hoglet67/SBC09/kicad/54020-44030LF.stp

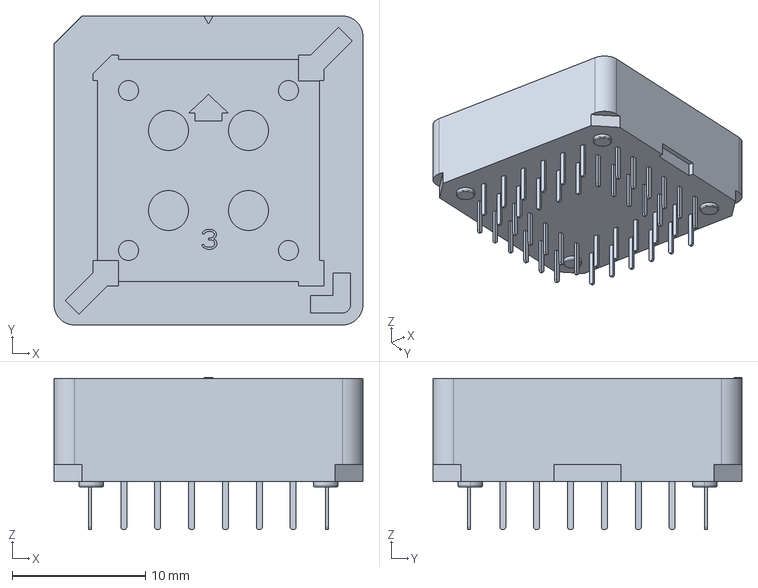
[picture p1: CAD file, 2023-04-21]
kicad/54020-44030LF.stp
23.2 x 23.2 x 11.4 mm
