hoglet67/SBC09/kicad/sbc09.pdf

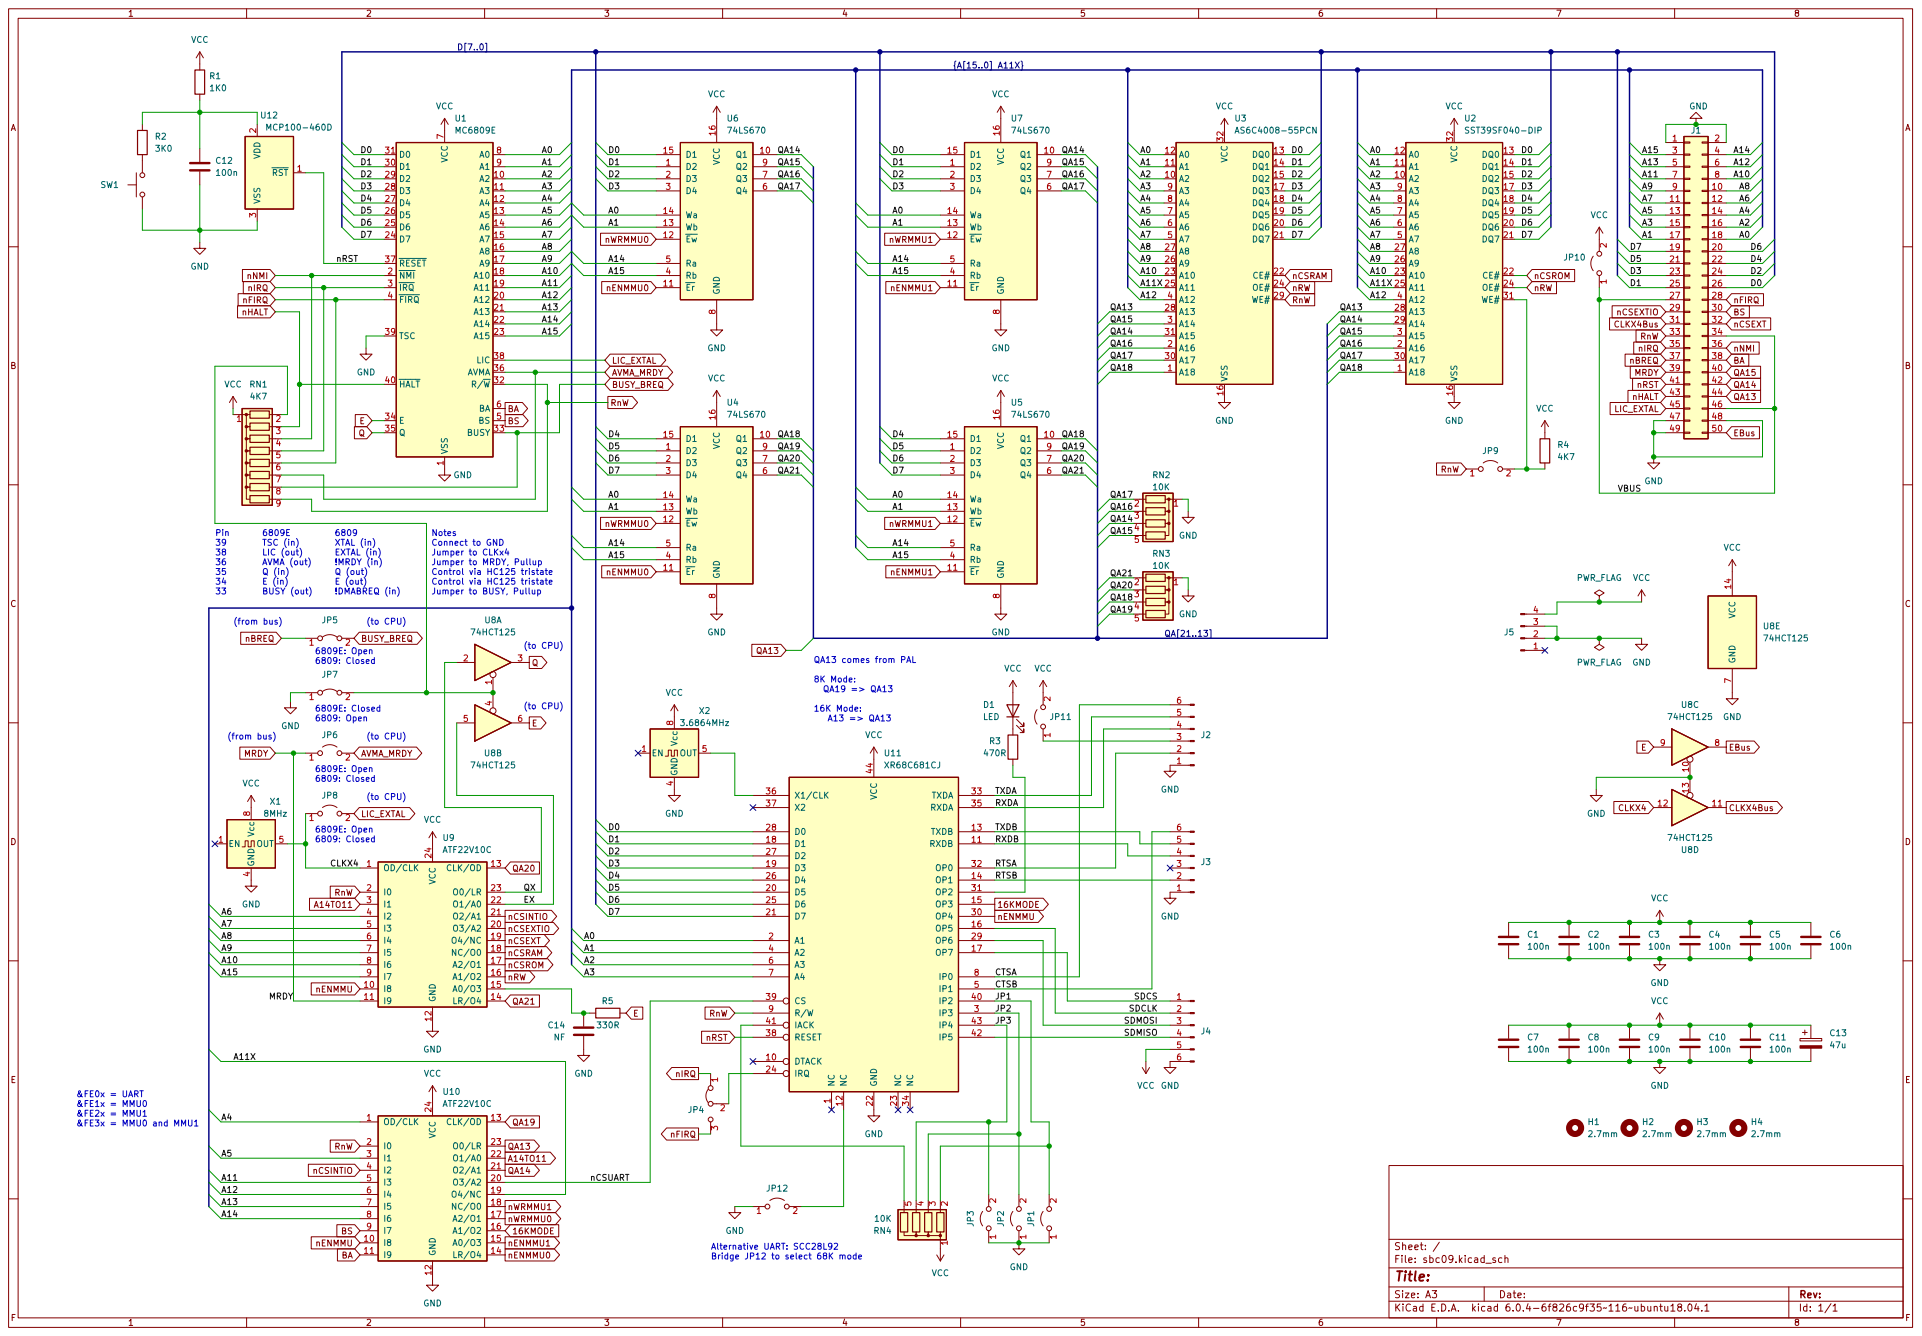
[picture p2: page 1]

38 LIC (out) EXTAL (in) Jumper to CLKx4
36 AVMA (out) !MRDY (in) Jumper to MRDY, Pullup
35 Q (in) Q (out) Control via HC125 tristate
34 E (in) E (out) Control via HC125 tristate
33 BUSY (out) !DMABREQ (in) Jumper to BUSY, Pullup

1 DTACK 10 RXDB 11 NC 12 TXDB 13 OP1 14 OP3 15 OP5 16 OP7 17 D1 18 D3 19 A1 2 D5 20 D7 21 GND 22 NC 23

Alternative UART: SCC28L92 Bridge JP12 to select 68K mode
