hoglet67/SBC09/kicad/sbc09.kicad_pcb

## KiCad design kicad/sbc09.kicad_pcb (2023-04-19)

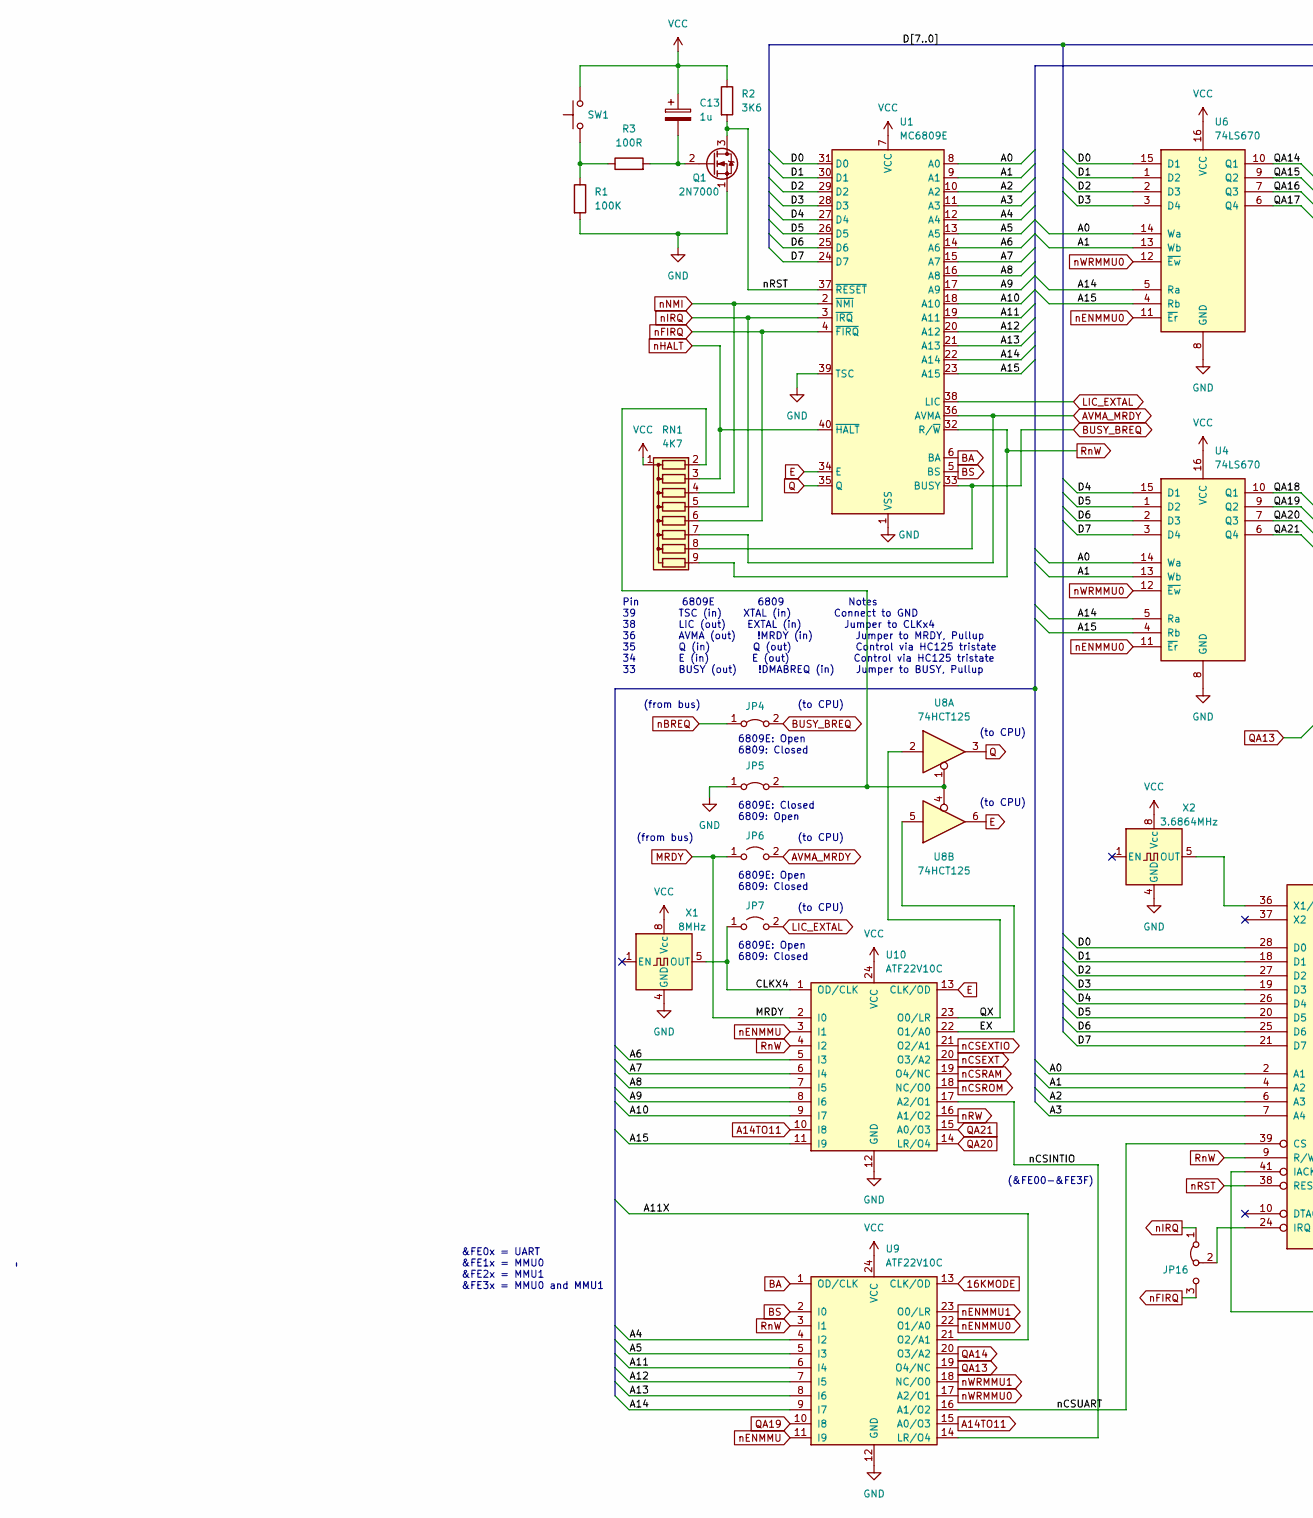
[picture p3: schematic sbc09.kicad_sch, part in row 1, column 1]

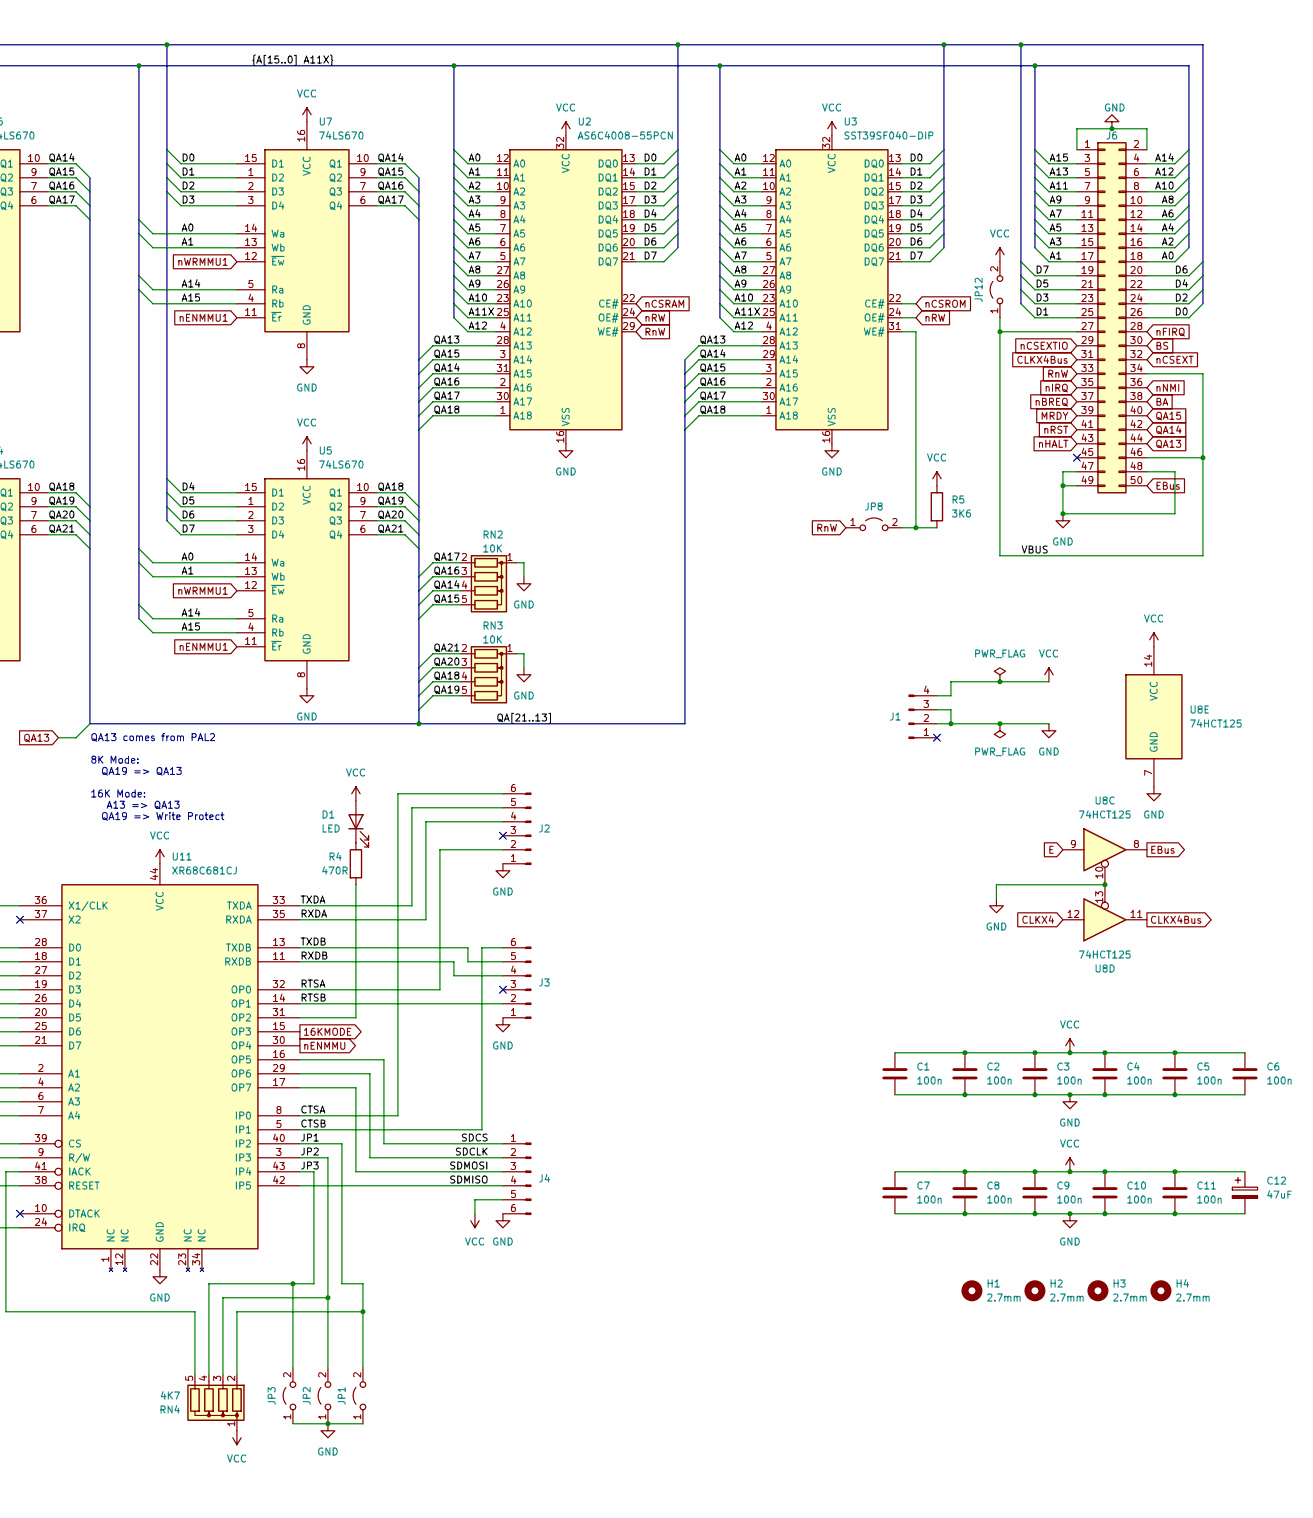
[picture p4: schematic sbc09.kicad_sch, part in row 1, column 2]

Parts:
C1, C2, C3, C4, C5, C6, C7, C8, C9, C10, C11: 100n; C_Disc_D4.7mm_W2.5mm_P5.00mm
C12: 47uF; CP_Radial_D5.0mm_P2.50mm
C13: 1u; CP_Radial_D5.0mm_P2.50mm
D1: LED; LED_D3.0mm_Horizontal_O1.27mm_Z2.0mm
H1, H2, H3, H4: 2.7mm; MountingHole_2.7mm
J1: Conn_01x04_Male; Molex_KK-254_AE-6410-04A_1x04_P2.54mm_Vertical
J2, J3, J4: Conn_01x06_Male; PinSocket_1x06_P2.54mm_Horizontal
J6: Conn_02x25_Odd_Even; IDC-Header_2x25_P2.54mm_Horizontal
JP1, JP2, JP3, JP6, JP7, JP8, JP12: Jumper_2_Open; PinHeader_1x02_P2.54mm_Vertical
JP4, JP5: Jumper_2_Bridged; PinHeader_1x02_P2.54mm_Vertical
JP16: Jumper_3_Bridged12; PinHeader_1x03_P2.54mm_Vertical
Q1: 2N7000; TO-92_Inline
R1: 100K; R_Axial_DIN0207_L6.3mm_D2.5mm_P10.16mm_Horizontal
R2, R5: 3K6; R_Axial_DIN0207_L6.3mm_D2.5mm_P10.16mm_Horizontal
R3: 100R; R_Axial_DIN0207_L6.3mm_D2.5mm_P10.16mm_Horizontal
R4: 470R; R_Axial_DIN0207_L6.3mm_D2.5mm_P10.16mm_Horizontal
RN1: 4K7; R_Array_SIP9
RN2, RN3: 10K; R_Array_SIP5
RN4: 4K7; R_Array_SIP5
SW1: SW_Push; SW_Tactile_SPST_Angled_PTS645Vx83-2LFS
U1: MC6809E; DIP-40_W15.24mm_Socket
U2: AS6C4008-55PCN; DIP-32_W15.24mm_Socket
U3: SST39SF040-DIP; DIP-32_W15.24mm_Socket
U4, U5, U6, U7: 74LS670; DIP-16_W7.62mm_Socket
U8: 74HCT125; DIP-14_W7.62mm_Socket
U9, U10: ATF22V10C; DIP-24_W7.62mm_Socket
U11: XR68C681CJ; PLCC-44_THT-Socket
X1: 8MHz; Oscillator_DIP-8
X2: 3.6864MHz; Oscillator_DIP-8

Connections:
16KMODE: U9.13 (CLK/OD), U11.15 (OP3)
/A0: J6.18, U1.8 (A0), U2.12 (A0), U3.12 (A0), U4.14 (Wa), U5.14 (Wa), U6.14 (Wa), U7.14 (Wa), U11.2 (A1)
/A1: J6.17, U1.9 (A1), U2.11 (A1), U3.11 (A1), U4.13 (Wb), U5.13 (Wb), U6.13 (Wb), U7.13 (Wb), U11.4 (A2)
/A2: J6.16, U1.10 (A2), U2.10 (A2), U3.10 (A2), U11.6 (A3)
/A3: J6.15, U1.11 (A3), U2.9 (A3), U3.9 (A3), U11.7 (A4)
/A4: J6.14, U1.12 (A4), U2.8 (A4), U3.8 (A4), U9.4 (I2)
/A5: J6.13, U1.13 (A5), U2.7 (A5), U3.7 (A5), U9.5 (I3)
/A6: J6.12, U1.14 (A6), U2.6 (A6), U3.6 (A6), U10.5 (I3)
/A7: J6.11, U1.15 (A7), U2.5 (A7), U3.5 (A7), U10.6 (I4)
/A8: J6.10, U1.16 (A8), U2.27 (A8), U3.27 (A8), U10.7 (I5)
/A9: J6.9, U1.17 (A9), U2.26 (A9), U3.26 (A9), U10.8 (I6)
/A10: J6.8, U1.18 (A10), U2.23 (A10), U3.23 (A10), U10.9 (I7)
/A11: J6.7, U1.19 (A11), U9.6 (I4)
/A11X: U2.25 (A11), U3.25 (A11), U9.21 (O2/A1)
/A12: J6.6, U1.20 (A12), U2.4 (A12), U3.4 (A12), U9.7 (I5)
/A13: J6.5, U1.21 (A13), U9.8 (I6)
/A14: J6.4, U1.22 (A14), U4.5 (Ra), U5.5 (Ra), U6.5 (Ra), U7.5 (Ra), U9.9 (I7)
/A15: J6.3, U1.23 (A15), U4.4 (Rb), U5.4 (Rb), U6.4 (Rb), U7.4 (Rb), U10.11 (I9)
/CTSA: J2.6, U11.8 (IP0)
/CTSB: J3.6, U11.5 (IP1)
/D0: J6.26, U1.31 (D0), U2.13 (DQ0), U3.13 (DQ0), U6.15 (D1), U7.15 (D1), U11.28 (D0)
/D1: J6.25, U1.30 (D1), U2.14 (DQ1), U3.14 (DQ1), U6.1 (D2), U7.1 (D2), U11.18 (D1)
/D2: J6.24, U1.29 (D2), U2.15 (DQ2), U3.15 (DQ2), U6.2 (D3), U7.2 (D3), U11.27 (D2)
/D3: J6.23, U1.28 (D3), U2.17 (DQ3), U3.17 (DQ3), U6.3 (D4), U7.3 (D4), U11.19 (D3)
/D4: J6.22, U1.27 (D4), U2.18 (DQ4), U3.18 (DQ4), U4.15 (D1), U5.15 (D1), U11.26 (D4)
/D5: J6.21, U1.26 (D5), U2.19 (DQ5), U3.19 (DQ5), U4.1 (D2), U5.1 (D2), U11.20 (D5)
/D6: J6.20, U1.25 (D6), U2.20 (DQ6), U3.20 (DQ6), U4.2 (D3), U5.2 (D3), U11.25 (D6)
/D7: J6.19, U1.24 (D7), U2.21 (DQ7), U3.21 (DQ7), U4.3 (D4), U5.3 (D4), U11.21 (D7)
/EX: U8.5, U10.22 (O1/A0)
/JP1: JP1.2 (B), RN4.2 (R1), U11.40 (IP2)
/JP2: JP2.2 (B), RN4.3 (R2), U11.3 (IP3)
/JP3: JP3.2 (B), RN4.4 (R3), U11.43 (IP4)
/QA16: RN2.3 (R2), U2.2 (A16), U3.2 (A16), U6.7 (Q3), U7.7 (Q3)
/QA17: RN2.2 (R1), U2.30 (A17), U3.30 (A17), U6.6 (Q4), U7.6 (Q4)
/QA18: RN3.4 (R3), U2.1 (A18), U3.1 (A18), U4.10 (Q1), U5.10 (Q1)
/QX: U8.2, U10.23 (O0/LR)
/RTSA: J2.2, U11.32 (OP0)
/RTSB: J3.2, U11.14 (OP1)
/RXDA: J2.4, U11.35 (RXDA)
/RXDB: J3.4, U11.11 (RXDB)
/SDCLK: J4.2, U11.29 (OP6)
/SDCS: J4.1, U11.16 (OP5)
/SDMISO: J4.4, U11.42 (IP5)
/SDMOSI: J4.3, U11.17 (OP7)
/TXDA: J2.5, U11.33 (TXDA)
/TXDB: J3.5, U11.13 (TXDB)
/VBUS: J6.27, J6.34, J6.46, JP12.1 (A)
/nCSINTIO: U9.14 (LR/O4), U10.17 (A2/O1)
/nCSUART: U9.16 (A1/O2), U11.39 (CS)
A14TO11: U9.15 (A0/O3), U10.10 (I8)
AVMA_MRDY: JP6.2 (B), RN1.7 (R6), U1.36 (AVMA)
BA: J6.38, U1.6 (BA), U9.1 (OD/CLK)
BS: J6.30, U1.5 (BS), U9.2 (I0)
BUSY_BREQ: JP4.2 (B), RN1.8 (R7), U1.33 (BUSY)
CLKX4: JP7.1 (A), U8.12, U10.1 (OD/CLK), X1.5 (OUT)
CLKX4Bus: J6.31, U8.11
E: U1.34 (E), U8.6, U8.9, U10.13 (CLK/OD)
EBus: J6.50, U8.8
GND: C1.2, C2.2, C3.2, C4.2, C5.2, C6.2, C7.2, C8.2, C9.2, C10.2, C11.2, C12.2, J1.2, J1.3, J2.1, J3.1, J4.6, J6.1, J6.2, J6.47, J6.48, J6.49, JP1.1 (A), JP2.1 (A), JP3.1 (A), JP5.1 (A), Q1.1 (S), R1.2, RN2.1 (common), RN3.1 (common), U1.1 (VSS), U1.39 (TSC), U2.16 (VSS), U3.16 (VSS), U4.8 (GND), U5.8 (GND), U6.8 (GND), U7.8 (GND), U8.7 (GND), U8.10, U8.13, U9.12 (GND), U10.12 (GND), U11.22 (GND), X1.4 (GND), X2.4 (GND)
LIC_EXTAL: JP7.2 (B), U1.38 (LIC)
MRDY: J6.39, JP6.1 (A), U10.2 (I0)
unnamed: C13.2, Q1.2 (G), R3.2
unnamed: D1.1 (K), R4.1
unnamed: JP5.2 (B), RN1.2 (R1), U8.1, U8.4
unnamed: JP16.2 (C), U11.24 (IRQ)
unnamed: R1.1, R3.1, SW1.1
unnamed: R4.2, U11.31 (OP2)
unnamed: RN4.5 (R4), U11.41 (IACK)
unnamed: JP8.2 (B), R5.2, U3.31 (WE#)
unnamed: U11.36 (X1/CLK), X2.5 (OUT)
Q: U1.35 (Q), U8.3
QA13: J6.44, U2.28 (A13), U3.28 (A13), U9.19 (O4/NC)
QA14: J6.42, RN2.4 (R3), U2.31 (A15), U3.29 (A14), U6.10 (Q1), U7.10 (Q1), U9.20 (O3/A2)
QA15: J6.40, RN2.5 (R4), U2.3 (A14), U3.3 (A15), U6.9 (Q2), U7.9 (Q2)
QA19: RN3.5 (R4), U4.9 (Q2), U5.9 (Q2), U9.10 (I8)
QA20: RN3.3 (R2), U4.7 (Q3), U5.7 (Q3), U10.14 (LR/O4)
QA21: RN3.2 (R1), U4.6 (Q4), U5.6 (Q4), U10.15 (A0/O3)
RnW: J6.33, JP8.1 (A), RN1.9 (R8), U1.32 (R/~W), U2.29 (WE#), U9.3 (I1), U10.4 (I2), U11.9 (R/W)
VCC: C1.1, C2.1, C3.1, C4.1, C5.1, C6.1, C7.1, C8.1, C9.1, C10.1, C11.1, C12.1, C13.1, D1.2 (A), J1.4, J4.5, JP12.2 (B), R2.1, R5.1, RN1.1 (common), RN4.1 (common), SW1.2, U1.7 (VCC), U2.32 (VCC), U3.32 (VCC), U4.16 (VCC), U5.16 (VCC), U6.16 (VCC), U7.16 (VCC), U8.14 (VCC), U9.24 (VCC), U10.24 (VCC), U11.44 (VCC), X1.8 (Vcc), X2.8 (Vcc)
nBREQ: J6.37, JP4.1 (A)
nCSEXT: J6.32, U10.20 (O3/A2)
nCSEXTIO: J6.29, U10.21 (O2/A1)
nCSRAM: U2.22 (CE#), U10.19 (O4/NC)
nCSROM: U3.22 (CE#), U10.18 (NC/O0)
nENMMU: U9.11 (I9), U10.3 (I1), U11.30 (OP4)
nENMMU0: U4.11 (~Er), U6.11 (~Er), U9.22 (O1/A0)
nENMMU1: U5.11 (~Er), U7.11 (~Er), U9.23 (O0/LR)
nFIRQ: J6.28, JP16.3 (B), RN1.6 (R5), U1.4 (~FIRQ)
nHALT: J6.43, RN1.3 (R2), U1.40 (~HALT)
nIRQ: J6.35, JP16.1 (A), RN1.5 (R4), U1.3 (~IRQ)
nNMI: J6.36, RN1.4 (R3), U1.2 (~NMI)
nRST: J6.41, Q1.3 (D), R2.2, U1.37 (~RESET), U11.38 (RESET)
nRW: U2.24 (OE#), U3.24 (OE#), U10.16 (A1/O2)
nWRMMU0: U4.12 (~Ew), U6.12 (~Ew), U9.17 (A2/O1)
nWRMMU1: U5.12 (~Ew), U7.12 (~Ew), U9.18 (NC/O0)

Notes on the sheet:
6809E: Open 6809: Closed
QA13 comes from PAL2 8K Mode: QA19 => QA13 16K Mode: A13 => QA13 QA19 => Write Protect
(to CPU)
6809E: Closed 6809: Open
&FE0x = UART &FE1x = MMU0 &FE2x = MMU1 &FE3x = MMU0 and MMU1
(from bus)
(&FE00-&FE3F)
Pin 6809E 6809 Notes 39 TSC (in) XTAL (in) Connect to GND 38 LIC (out) EXTAL (in) Jumper to CLKx4 36 AVMA (out) !MRDY (in) Jumper to MRDY, Pullup 35 Q (in) Q (out) Control via HC125 tristate 34 E (in) E (out) Control via HC125 tristate 33 BUSY (out) !DMABREQ (in) Jumper to BUSY, Pullup
6809E: Open 6809: Closed

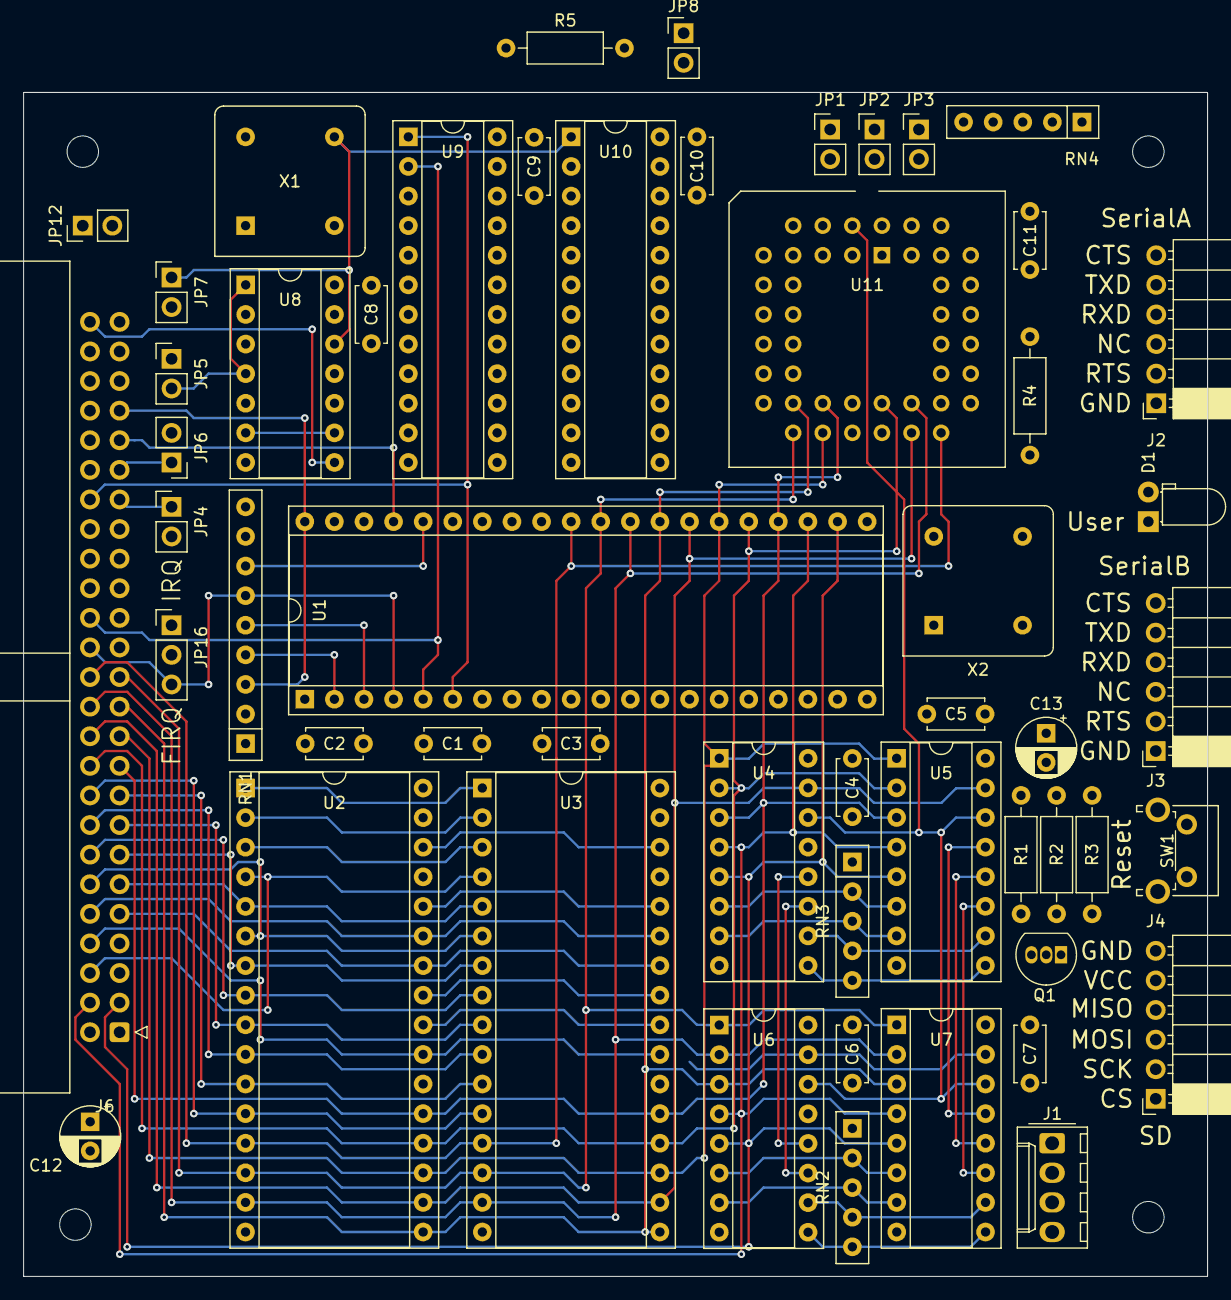
[picture p5: board sbc09.kicad_pcb from above]

Board: 4 copper layers, 101.6 x 101.6 mm, 57 parts (0 on the bottom side), 95 nets.
