hoglet67/SBC09/(commit log)

2022-10-05 Version with two 74LS670 and one 22V10
    [sbc09.kicad_pcb, sbc09.kicad_sch]
2022-10-05 Version with four 74LS670 and two 22V10
    [sbc09.kicad_sch]
2022-10-07 Two oscillators, added QA13
    [sbc09.kicad_sch]
2022-10-07 Use A14/15 instead of RA/RB
    [sbc09.kicad_sch]
2022-10-07 QA13 generated by PAL
    [sbc09.kicad_sch]
2022-10-12 Fix error in signals passed between PALs
    [sbc09.kicad_sch]
2022-10-12 Try passing A12_A11_A10 between PALs
    [sbc09.kicad_sch]
2022-10-12 Better partitioning of PALs
    [sbc09.kicad_sch]
2022-10-12 Started work on PCB
    [sbc09.kicad_pcb, sbc09.kicad_sch]
2022-10-13 Started manually routing the board
    [sbc09.kicad_pcb, sbc09.kicad_sch]
2022-10-14 Fix warnings
    [sbc09.kicad_sch]
2022-10-14 Update IC references
    [sbc09.kicad_sch]
2022-10-14 Changed Bus Connector from Female to Male
    [sbc09.kicad_sch]
2022-10-14 Set min spacing to 8 mils and fixes a couple of minor violations
2022-10-15 Changed Bus Connector from Male back to Female
    [sbc09.kicad_sch]
2022-10-15 Buffer E/Q on Bus
    [sbc09.kicad_sch]
2022-10-15 Updated PDF Schematic
2022-10-24 Shrinking used space: work in progress
    [sbc09.kicad_sch]
2022-10-25 Tweak board placement; DIP-8 oscillators
    [sbc09.kicad_sch]
2022-10-25 Tweak board placement again to make gaps more even
2022-10-25 Messing with front panel connectors
    [sbc09.kicad_sch]
2022-10-25 Moved LED to front panel
2022-10-25 Change board stackup to br 1.6mm
2022-10-25 OCD tweaking around MAX232E
    [sbc09.kicad_sch]
2022-10-26 Moved reset components close to front panel
    [sbc09.kicad_sch]
2022-10-26 Started labelling
    [sbc09.kicad_sch]
2022-10-26 Name serial port nets
    [sbc09.kicad_sch]
2022-10-26 Replaced 9-pin D-Sub with 10-pin header
    [sbc09.kicad_sch]
2022-10-26 Replaced 2x5 header with polarized box header
    [sbc09.kicad_sch]
2022-10-26 Move power connector
2022-10-28 Use 5mm pitch decoupling caps
    [sbc09.kicad_sch]
2022-10-28 Make bus connector a MALE pin header
    [sbc09.kicad_sch]
2022-10-28 Minor component movement around UART
2022-10-31 PAL2: Push negation into pins (same jedec fusemap)
2022-10-31 PAL2: Select devices based to A15/A14 when MMU disabled
2022-10-31 PAL1: Push negation into pins (same jedec fusemap)
2022-10-31 KiCAD: Swap CSxxx select pins
    [sbc09.kicad_sch]
2022-10-31 KiCAD: Route QA14 to spare PAL2 input
    [sbc09.kicad_sch]
2022-11-03 PCB: Change order of QA19/20/21
    [sbc09.kicad_sch]
2022-11-03 Added JP17 to select between IRQ and FIRQ for the UART interrupt
    [sbc09.kicad_sch]
2022-11-03 Added pullup to RnW so it doesn't float during SYNC
    [sbc09.kicad_sch]
2022-11-03 Remove JP8 (caused fast clock stub) and renumbered remaining JPs
    [sbc09.kicad_sch]
2022-11-03 Replace J1 (ext power) with Molex KK
    [sbc09.kicad_sch]
2022-11-03 Control direction of Addr buffers from BA
    [sbc09.kicad_sch]
2022-11-03 Change value of U1/2/3 to 74HCT245
    [sbc09.kicad_sch]
2022-11-03 Correct comment on schematic
    [sbc09.kicad_sch]
2023-04-16 KiCAD: cost reducing
    [sbc09.kicad_sch]
2023-04-19 KiCAD: more work...
    [sbc09.kicad_pcb, sbc09.kicad_sch]
2023-04-20 KiCAD: kill some vias
2023-04-21 Renumber jumpers
    [sbc09.kicad_sch]
2023-04-21 Correct SD card connections to UART
    [sbc09.kicad_sch]
2023-04-21 Added PLCC socket and DIP packages to 3D model
    [54020-44030LF.stp]
2023-04-21 Cosmetic + update PDF
    [sbc09.kicad_sch]
2023-04-22 Fix couple of errors in PALs
2023-04-22 Add RC filter for E going into PAL
    [sbc09.kicad_sch]
2023-04-22 Update PDF schematic
2023-04-22 Silk screen
    [sbc09.kicad_sch]
2023-04-22 Added jumper for power from SerialA
    [sbc09.kicad_sch]
2023-05-05 Added JP12 (for 28L92 option) and route LIC to edge connector
    [sbc09.kicad_sch]
2023-06-14 Update reset to use MCP100
    [sbc09.kicad_sch]
2023-06-14 Swap couple of refs; set solder mask clarance / min width
    [sbc09.kicad_sch]
2023-06-14 Silkscreen only
2023-06-15 Added manufacturing files
    [sbc09-B_Cu.gbl, sbc09-B_Mask.gbs, sbc09-B_Silkscreen.gbo, sbc09-Edge_Cuts.gm1, sbc09-F_Cu.gtl, sbc09-F_Mask.gts, sbc09-F_Silkscreen.gto, sbc09-NPTH.drl]
